robertkirsten/laundrybox/README.md

# LaundryBox

LaundryBox is a TMS course project at TUM for detecting foreign objects in
garments handled by professional garment-leasing and industrial-laundry
services.

## Project concept

Each garment already carries an RFID tag. LaundryBox combines that identity
with a garment-specific weight comparison to decide whether a returned garment
needs to be inspected manually. A barcode can serve as a documented fallback if
RFID proves technically infeasible.

The return station is envisioned as a box similar to a Decathlon self-checkout
bin. It integrates:

- an RFID reader to identify the garment, with barcode as a fallback;
- a scale to measure its current weight;
- optionally, a DC electromagnetic sensing system for ferromagnetic objects if
  the current feasibility tests succeed; and
- a two-state traffic-light interface that communicates the inspection decision
  to an operator.

## Intended workflow

### 1. Clean garment leaves the laundry

1. The garment's RFID tag is read.
2. The clean garment is weighed.
3. Its measured reference weight is stored or updated in the database and
   associated with the RFID identifier.

The same physical scale may be used for clean reference and return measurements.

### 2. Dirty garment is returned

1. The RFID tag is read again.
2. The returned garment is weighed in the LaundryBox.
3. The corresponding clean reference weight is retrieved from the database.
4. The system applies either no contamination correction or a documented,
   configurable fixed offset until sufficient data exists for individual
   learning.
5. The normalized weight difference is used as evidence for or against the
   presence of a foreign object.
6. Magnetic sensing can provide an additional signal for ferromagnetic foreign
   objects if feasibility testing supports its inclusion.

A future system may learn the typical contamination of each individual garment
from its return history.

### 3. Operator decision

The system displays a two-state traffic-light result:

- **PASS / green:** no manual inspection indicated.
- **CHECK / red:** manual inspection required because an object is suspected or
  the result is uncertain.

The decision threshold prioritizes sensitivity because missed damaging objects
are considered more costly than unnecessary manual checks.

## Current scope and assumptions

- The target users are professional garment-leasing or industrial-laundry
  operators, not private households.
- Every garment can be identified by RFID or, if necessary, by a barcode
  fallback, and has a reference-weight record.
- The outbound clean weight is the garment-specific reference value.
- The system evaluates garments from 50 g to 1,000 g and targets a decision time
  of at most 10 seconds.
- Individual dirt normalization is a future enhancement; the current system
  uses no correction or a configurable fixed offset.
- Built-in metallic garment components such as zippers, buttons, and fasteners
  are assumed to be non-ferromagnetic. This assumption must be tested against
  the actual garment inventory.
- If included, the magnetic subsystem is intended to detect ferromagnetic
  material; it will not detect every metal or every possible foreign object.
- The system recommends whether a human check is needed; it does not
  automatically remove the object.

## Core project question

Can a garment-specific weight difference identify damaging foreign objects with
very high sensitivity while keeping the number of unnecessary manual checks
manageable, and can magnetic sensing improve that decision?

## Status

This README records the team's initial agreed project baseline. Hardware
architecture, sensing method, object classes, performance targets, safety
requirements, and evaluation design remain open for the next project phase.

The consolidated product requirements are maintained in
[REQUIREMENTS.md](REQUIREMENTS.md).

Raspberry Pi startup, operation, serial diagnostics, and troubleshooting are
documented in [docs/RASPBERRY_PI_RUNBOOK.md](docs/RASPBERRY_PI_RUNBOOK.md).

For development, run both backend and frontend with:

```sh
./argus dev
```

Validate the complete checkout with `./argus check`; install or update a Pi
with `sudo ./argus install` and `sudo ./argus deploy` respectively.
