robertkirsten/laundrybox/frontend/roadmap.md

# Roadmap

- [x] Build 3-screen kiosk flow (Schacht → Bitte prüfen → Gegenstand wählen) in Gallery Lightbox design
- [x] Fast throughput: minimal interactions, big touch targets, auto-return after selection
- [x] Live clock, operator + scan count in top bar; green/red status frame
