robertkirsten/laundrybox/docs/RASPBERRY_PI_RUNBOOK.md

# Raspberry Pi runbook

ARGUS has two entry points:

- `./argus` operates from the source checkout for development, validation, and deployment.
- `argusctl` operates the installed production system.

The commands assume sibling checkouts at `~/laundrybox` and `~/smart-shaft`.
Set `ARGUS_FRONTEND_DIR=/another/path` when the frontend is elsewhere.

## Development

From the LaundryBox checkout, run the whole system with one command:

```sh
cd ~/laundrybox
./argus dev
```

On its first run this command creates the Python environment, installs missing
frontend dependencies, migrates and seeds SQLite, and starts both applications:

- frontend: `http://127.0.0.1:3000`
- backend: `http://127.0.0.1:8000`
- API documentation: `http://127.0.0.1:8000/docs`

`Ctrl+C` stops both processes. Development configuration is stored in
`backend/.env`, and development data is stored in
`backend/var/argus.sqlite3`.

Run all available checks with:

```sh
./argus check
```

This runs Python lint/tests, frontend lint and the Pi production build, plus the
firmware build when PlatformIO is installed.

## First production installation

Install the native build prerequisite used by the Raspberry Pi GPIO dependency:

```sh
sudo apt update
sudo apt install -y swig liblgpio-dev
```

Install from the current two checkouts:

```sh
cd ~/laundrybox
sudo ./argus install
```

The installer builds both applications before stopping anything, installs
systemd services, configures the Teensy udev name, enables daily SQLite backups,
and verifies ports 8000 and 3000. If a development database exists and no
production database exists yet, it is migrated with SQLite's online backup API.

Production locations are intentionally fixed:

- application releases: `/opt/argus/releases`
- active application links: `/opt/argus/laundrybox`, `/opt/argus/smart-shaft`
- configuration: `/etc/argus/argus.env`
- editable garment fixture: `/etc/argus/mock_garments.csv`
- database: `/var/lib/argus/argus.sqlite3`
- verified backups: `/var/lib/argus/backups`

Point the Pi's Chromium kiosk at `http://127.0.0.1:3000`.

## Production updates

Update both source checkouts, then deploy them together:

```sh
cd ~/laundrybox
git pull
cd ~/smart-shaft
git pull
cd ~/laundrybox
sudo ./argus deploy
```

The deployment is staged and built before the running services stop. It backs
up SQLite, switches the active release, runs migrations through systemd, starts
both services, and checks backend and frontend HTTP endpoints. A failed startup
restores the previous active release.

## Daily operation

```sh
argusctl status
argusctl start
argusctl stop
argusctl restart
argusctl health
argusctl state
argusctl logs
```

The services start automatically after a Pi reboot.

## Clean garment scan log

Show the latest completed scans:

```sh
argusctl scans
```

Follow new scans live:

```sh
argusctl scans --follow
```

Other useful forms are:

```sh
argusctl scans --last 50
argusctl scans --last 50 --csv
```

The default output intentionally contains only EPC, garment, measured weight
(`IST`), and reference weight (`SOLL`). Technical logs remain under
`argusctl logs`.

## Raw Teensy serial

Use the safe wrapper rather than opening `/dev/ttyACM0` directly:

```sh
argusctl serial
```

Exit with `Ctrl+C`. The command remembers whether the backend was active,
temporarily stops it so only one process owns the serial port, and restores it
on exit. For an automatically bounded capture:

```sh
argusctl serial --seconds 15
argusctl serial --lines 30
```

Set `ARGUS_LOG_LEVEL=DEBUG` in `/etc/argus/argus.env` and restart the backend
when raw Teensy lines should also appear in the technical journal.

## Database and backup

Open the production database read-only:

```sh
argusctl db
```

Trigger a verified backup immediately:

```sh
argusctl backup
```

The daily timer retains the latest 14 verified backups. Deployments never reset
or replace the production database.

## Configuration changes

All production settings live in a single file:

```
/etc/argus/argus.env
```

To change a setting, edit the file and restart the backend:

```sh
sudo nano /etc/argus/argus.env
sudo argusctl restart
```

Verify the backend picked up the change:

```sh
argusctl health
```

### Available settings

| Variable | Default | Description |
| --- | --- | --- |
| `ARGUS_LOG_LEVEL` | `INFO` | Python log level (`DEBUG`, `INFO`, `WARNING`, `ERROR`) |
| `ARGUS_JSON_LOGS` | `true` | Emit structured JSON logs (`true`) or plain text (`false`) |
| `ARGUS_SERIAL_PORT` | `/dev/argus-teensy` | Primary Teensy serial device |
| `ARGUS_SERIAL_FALLBACK_PORT` | `/dev/ttyACM0` | Fallback if the udev symlink is missing |
| `ARGUS_SERIAL_ENABLED` | `true` | Disable to run without a Teensy (e.g. for UI-only testing) |
| `ARGUS_SERIAL_STALE_AFTER_S` | `2.0` | Seconds without a Teensy report before health shows stale |
| `ARGUS_THRESHOLD_G` | `3.0` | Weight difference (grams) that triggers a CHECK decision |
| `ARGUS_EMPTY_WEIGHT_MAX_G` | `10.0` | Maximum weight (g) considered an empty scale |
| `ARGUS_MIN_GARMENT_WEIGHT_G` | `50.0` | Minimum weight (g) to accept as a garment |
| `ARGUS_MAX_GARMENT_WEIGHT_G` | `1000.0` | Maximum weight (g) to accept as a garment |
| `ARGUS_STABILITY_TOLERANCE_G` | `2.0` | Total range (g) for readings to be considered stable |
| `ARGUS_STABILITY_WINDOW_SIZE` | `3` | Consecutive readings that must be within tolerance |
| `ARGUS_REMOVAL_CONFIRM_SAMPLES` | `3` | Consecutive light readings before confirming garment removal |
| `ARGUS_MINIMUM_TAG_READS` | `2` | Minimum RFID tag reads before accepting a scan |
| `ARGUS_ACQUISITION_TIMEOUT_S` | `6.0` | Seconds to wait for stable weight before timing out |
| `ARGUS_INSPECTION_TIMEOUT_S` | `30.0` | Seconds a CHECK stays on screen before auto-completing |
| `ARGUS_FEEDBACK_DISPLAY_S` | `3.0` | Seconds the feedback confirmation is shown |
| `ARGUS_METAL_CHECK_ENABLED` | `true` | Whether ferrous metal detection forces a CHECK |
| `ARGUS_SEED_MOCK_DATA` | `true` | Seed garments from the CSV fixture on startup |
| `ARGUS_MOCK_DATA_PATH` | `/etc/argus/mock_garments.csv` | Path to the garment fixture CSV |
| `ARGUS_ENABLE_DEBUG_INGEST` | `false` | Enable the `POST /api/v1/debug/reports` endpoint |
| `ARGUS_NEOPIXEL_ENABLED` | `true` | Enable the addressable LED status strip |
| `ARGUS_NEOPIXEL_COUNT` | `60` | Number of pixels on the strip |
| `ARGUS_NEOPIXEL_BRIGHTNESS` | `0.3` | Brightness (0.0–0.5); values above 0.5 are rejected |
| `ARGUS_STATION_CODE` | `ARGUS-01` | Station identifier shown in the UI and stored in cycles |
| `ARGUS_OPERATOR_NUMBER` | `4471` | Default operator number |
| `ARGUS_CORS_ORIGINS` | `["http://127.0.0.1:3000", ...]` | Allowed CORS origins (JSON array) |

> [!NOTE]
> Deployments (`sudo ./argus deploy`) never overwrite `/etc/argus/argus.env`.
> Only `sudo ./argus install` creates the initial file from the template.
> The garment CSV at `/etc/argus/mock_garments.csv` is likewise only copied on
> first install; editing it and restarting the backend seeds new rows without
> removing existing garments.

## Addressable status strip

The strip used by ARGUS is a 5 V, individually addressable, dual-data-path RGB
strip in the WS2813 family (or a pin-compatible equivalent). Its `DI`/`BI` pads
are inputs, its `DO`/`BO` pads are outputs, and the arrows printed on the strip
point from the controller end towards the output end. Connect only at the end
marked `DI` and `BI`.

The backend drives the strip directly from Raspberry Pi SPI. A completed `PASS`
decision fills it green, a completed `CHECK` decision fills it red, and all
other states (startup, waiting, acquiring, unavailable, and shutdown) switch it
off. No Pi-to-Teensy command is involved.

### Wiring

Power down and unplug the Pi before changing connections. This prototype uses
60 pixels and displays only red or green, never a mixture of RGB channels. The
brightness is capped at 50%. Under those constraints the strip is
powered from the Pi's 5 V rail;
never power it from a GPIO or the 3.3 V pin.

| Strip connection | Connect to |
| --- | --- |
| `+5V` | Raspberry Pi 5 V, physical pin 2 or 4 |
| `GND` | Raspberry Pi GND, for example physical pin 6 |
| `DI` | Raspberry Pi SPI0 MOSI, BCM10/physical pin 19, through 470 ohms |
| `BI` | GND at the first pixel |
| `DO`, `BO` | Leave disconnected; these are outputs at the far end |

Keep the MOSI-to-`DI` wire short. The photographed pinout is consistent with
WS2813B V5, whose specified 2.7 V minimum logic-high level accepts the Pi's
3.3 V signal without a level shifter. The 470 ohm resistor limits transient
current and suppresses ringing; it does not materially lower the logic voltage.

SPI0 must be enabled before deploying:

```sh
sudo raspi-config nonint do_spi 0
sudo reboot
ls -l /dev/spidev0.0
```

The NeoPixel SPI driver uses MOSI to synthesize the 800 kHz pixel waveform, so
SPI0 cannot simultaneously be used for another peripheral. ARGUS's RFID and
scale data arrive over the Teensy's USB serial connection and do not conflict.

The deployed configuration matches the one-metre prototype and defaults to 30%.
Brightness is configurable from 0.0 to 0.5; larger values are rejected. The
driver also rejects any color that would activate multiple RGB channels
simultaneously.

```sh
ARGUS_NEOPIXEL_ENABLED=true
ARGUS_NEOPIXEL_COUNT=60
ARGUS_NEOPIXEL_BRIGHTNESS=0.3
sudo argusctl restart
```

The driver uses GRB byte order and a 300 microsecond reset interval suitable for
WS2813B. It only emits red, green, or off. If SPI or the LED library cannot
initialize, the backend logs the error and continues without the strip so the
inspection UI remains operational.

Test the wiring with:

```sh
argusctl led-test
```

The command temporarily stops the backend so only one process owns SPI, fills
the entire strip red and then green, clears the strip on exit, and then restores
the backend. Brightness remains limited by `ARGUS_NEOPIXEL_BRIGHTNESS`. Useful
options are `--color red`, `--color green`, `--brightness 0.5`, `--delay 5`, and
`--cycles 2`; `--delay` controls how many seconds each solid color remains
visible. Without `--brightness`, the command uses `ARGUS_NEOPIXEL_BRIGHTNESS`.

To invoke the Python test directly from a source checkout, first stop the
backend so it does not write to SPI concurrently, then use the backend virtual
environment:

```sh
sudo systemctl stop argus-backend.service
cd ~/laundrybox/backend
.venv/bin/python scripts/led_test.py --env-file .env
sudo systemctl start argus-backend.service
```

When the virtual environment is already activated, the middle command is simply
`python scripts/led_test.py --env-file .env`. The script accepts the same
`--color`, `--brightness`, `--delay`, and `--cycles` options and always clears
the strip on exit.

The garment CSV is copied to `/etc/argus/mock_garments.csv` only on first
installation, so deployments do not overwrite local garments. New rows are
seeded when the backend restarts; existing database garments are not
destructively rewritten by the fixture importer.

## Common failures

If `./argus dev` reports port 3000 or 8000 in use, stop production first:

```sh
sudo argusctl stop
```

Installations created before the unified ARGUS services may still have a
legacy `smart-shaft.service`. Current deployments disable it automatically. To
remove the conflict manually before deploying, run:

```sh
sudo systemctl disable --now smart-shaft.service
```

If the Teensy is not detected:

```sh
ls -l /dev/argus-teensy /dev/ttyACM0 2>/dev/null
lsusb
dmesg --ctime | tail -n 40
```

If production does not start:

```sh
argusctl status
argusctl logs
```

Always shut the Pi down before removing power:

```sh
sudo poweroff
```
