robertkirsten/laundrybox/hardware/electronics/laundrybox_wiring.png

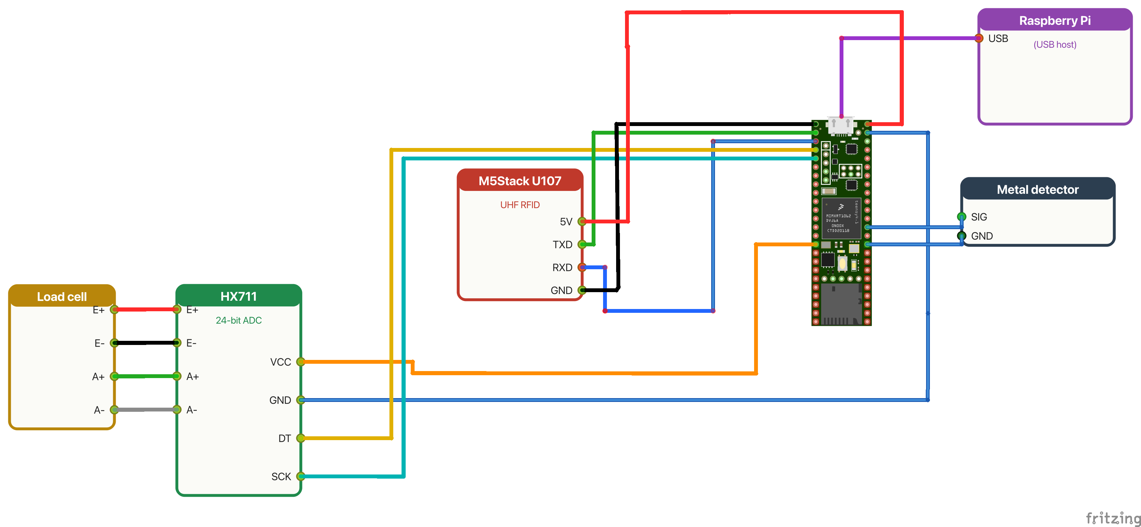
hardware/electronics/laundrybox_wiring.png
