robertkirsten/laundrybox/(list of files, drawings)

Other design files:
hardware/electronics/laundrybox.fzz
