robertkirsten/laundrybox/(commit log)

2026-09-15 Add simple hardware diagram
    [laundrybox.fzz]
2026-09-16 More power
2026-09-16 Update calibration firmware
2026-09-16 Changes from review
    [mock_garments.csv]
2026-09-16 Backend improvements
    [.git_diff_output.txt]
2026-09-16 Add teensy pinouts and fritzing part
2026-09-16 Update wiring diagram
    [laundrybox.fzz]
2026-09-16 Move electronics hardware to distinct dir
    [laundrybox.fzz]
2026-09-17 Add LED strip
2026-09-17 LED improvements
2026-09-17 Green LED confirmation flash after CHECK feedback
    After an operator records inspection feedback on a CHECK result, the LED
    strip now briefly shows green (confirmation) instead of staying red. The
    display holds for feedback_display_s (default 3 seconds) before the station
    returns to WAITING (LED off).
    Changes:
    - status_led: feedback_recorded overrides CHECK red with green
    - state_machine: delay reset to WAITING by feedback_display_s after feedback
    - config: add ARGUS_FEEDBACK_DISPLAY_S setting (default 3.0)
    - tests: updated to cover the delayed transition
    [config.py, state_machine.py, status_led.py]
2026-09-17 Flash LED to confirm feedback, force LED off on shutdown
    - status_led now runs an async background flash sequence (3 flashes) when feedback is recorded.
    - Shows green flash for NOTHING_FOUND, and red flash for anything else (SOMETHING_FOUND).
    - Bypasses color dedup on shutdown to ensure the LED really turns off when the backend exits.
2026-09-17 firmware: Make IDLE mode command non-fatal
    The IDLE mode command (0x04) is not acknowledged by all U107
    revisions. This makes the firmware fall back to best-effort behavior
    (similar to transmit power) so that the scale and polling cycle still
    function on these modules.
2026-09-17 firmware: Improve UART synchronization and error recovery
    - Wait for true UART silence before sending commands (TxPower, IDLE, Info, Poll)
    to avoid half-duplex collisions with delayed tag notifications.
    - Do not immediately abort `waitForOkResponse` if a malformed frame is read;
    keep trying until the timeout is reached. This helps recover from UART noise
    or truncated frames when tags are transmitting.
    [config.h]
2026-09-17 firmware: Prevent infinite loops during UART flush
    Replaces the unbounded `while (true)` flush loop with a bounded `for` loop (max 10 iterations / 20 ms). This ensures the Teensy won't hang indefinitely (and stop sending JSON to the backend over USB) if the RFID module gets stuck continuously transmitting data or if there's electrical noise.
2026-09-17 backend: Fix fallback serial port resolution
    Previously, the serial reader would only try to open the very first
    candidate port that returned True for `exists()`. If that port existed
    but threw an OSError during opening (e.g., dead symlink, wrong permissions),
    it would loop indefinitely trying to reopen it and never attempt to use
    the fallback port.
    Now it properly evaluates and tries to open all existing candidate
    ports in sequence, making the fallback port feature actually work.
    [serial_reader.py]
2026-09-17 Add quickly cooked calibration for 4 load cells
2026-09-17 Correct load cell pins
    [config.h]
2026-09-17 New calibration factors
2026-09-17 Update metal detector analog pin
2026-09-17 Different calibration methods
